Picatout/pong/resources/montage-sans-soudure.JPG

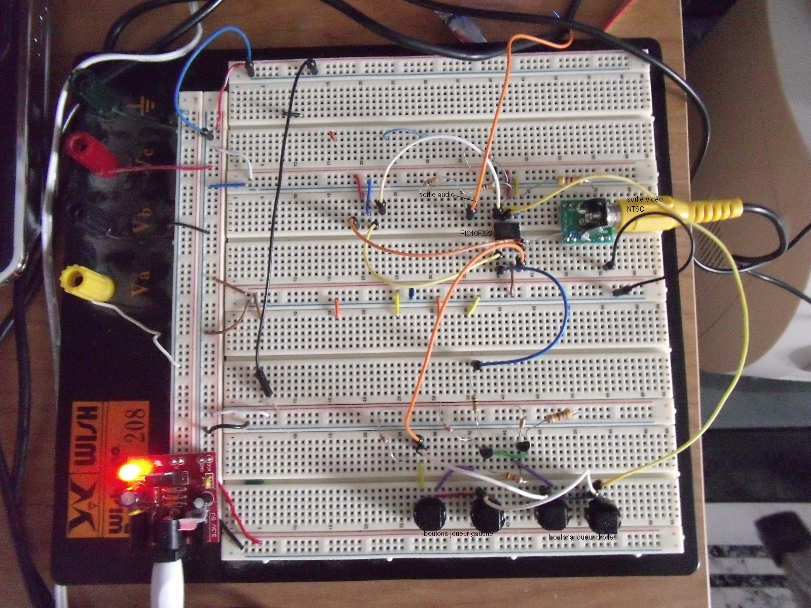
resources/montage-sans-soudure.JPG
