Picatout/pong/readme.txt

Jeux pong avec sortie vidéo NTSC et audio  réalisé sur PIC10F322.
