Picatout/pong/resources/pong_schematic.png

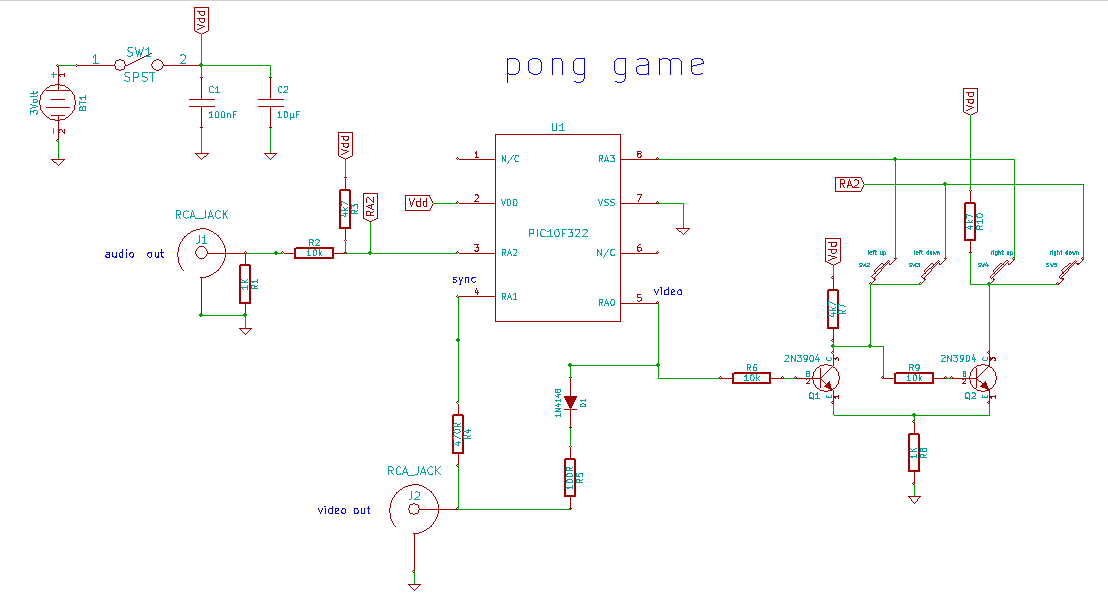
resources/pong_schematic.png
