Picatout/pong/resources/pong.sch

## KiCad design resources/pong.sch (2013-08-18)

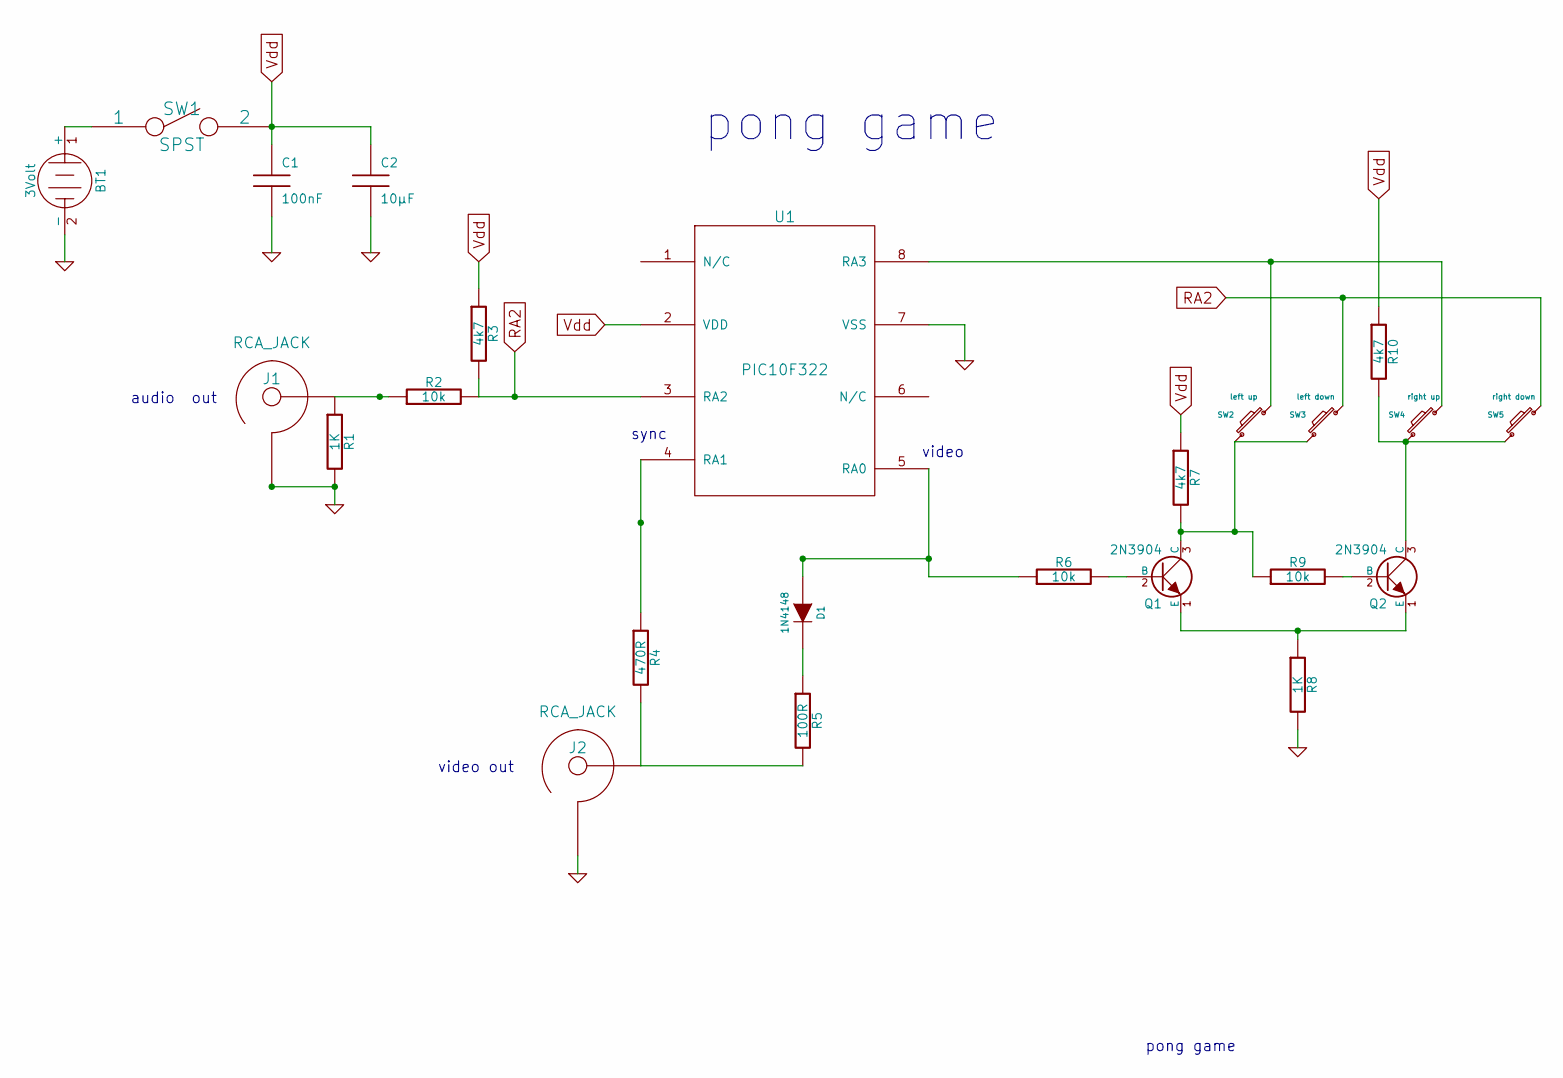
[picture p3: schematic pong.sch]

Parts:
BT1: 3Volt
C1: 100nF
C2: 10µF
D1: 1N4148
J1, J2: RCA_JACK
Q1, Q2: 2N3904
R1, R8: 1K
R2, R6, R9: 10k
R3, R7, R10: 4k7
R4: 470R
R5: 100R
SW1: SPST
SW2: left up
SW3: left down
SW4: right up
SW5: right down
U1: PIC10F322

Connections:
GND: BT1.2 (-), C1.2, C2.2, J1.~, J2.~, R1.2, R8.2, U1.7 (VSS)
unnamed: BT1.1 (+), SW1.1
unnamed: D1.1 (A), R6.1, U1.5 (RA0)
unnamed: D1.2 (K), R5.1
unnamed: J1.~, R1.1, R2.1
unnamed: J2.~, R4.2, R5.2
unnamed: Q1.1 (E), Q2.1 (E), R8.1
unnamed: Q1.2 (B), R6.2
unnamed: Q1.3 (C), R7.2, R9.1, SW2.2, SW3.2
unnamed: Q2.2 (B), R9.2
unnamed: Q2.3 (C), R10.2, SW4.2, SW5.2
unnamed: R4.1, U1.4 (RA1)
unnamed: SW2.1, SW4.1, U1.8 (RA3)
RA2: R2.2, R3.2, SW3.1, SW5.1, U1.3 (RA2)
Vdd: C1.1, C2.1, R3.1, R7.1, R10.1, SW1.2, U1.2 (VDD)

Notes on the sheet:
video out
audio out
video
sync
pong game
pong game
