Picatout/pong/(commit log)

2013-08-17 premier commit
    [pong.sch]
2013-08-18 modification chemin include du fichier pic10f322_m.inc dans mini-poing.asm
    [$pong.sch]
2013-08-18 modification au circuit, remplacé vidéo
    [$pong.sch, pong.sch]
2013-08-18 modified schematic and routines ball_control, buttons
    [$pong.sch]
2013-08-18 modification projet kicad
    [$pong.sch, pong.sch]
